onurefe/Wirebonder/Hardware/bom.xlsx

Part | Value | Link | Price | Qty
C1, C2 | 0.47u | https://ozdisan.com/passive-components/capacitors/smt-smd-and-mlcc-capacitors/CL10B474KO8NNNC | 0.00926 | 2 | 0.01852
C3-C8, C13, C16-C19, C21-C25, C30, C32, C38, C41, C45-C48, C51, C52, C56-C58, C60, C64, C66-C81, C87, C89 | 100n | https://ozdisan.com/passive-components/capacitors/smt-smd-and-mlcc-capacitors/CL10B104KB8NNNC | 0.00448 | 49 | 0.21952
C9, C10 | 10n | https://ozdisan.com/passive-components/capacitors/smt-smd-and-mlcc-capacitors/CL10B103KB8NNNC | 0.00532 | 2 | 0.01064
C11, C12 | 18p | https://ozdisan.com/passive-components/capacitors/smt-smd-and-mlcc-capacitors/CL10C180JB8NNNC | 0.00487 | 2 | 0.00974
C14 | 4.7u | https://ozdisan.com/passive-components/capacitors/smt-smd-and-mlcc-capacitors/CL10A475KQ8NNNC | 0.01079 | 1 | 0.01079
C15, C20, C86, C88, C90, C93, C94 | 1u | https://ozdisan.com/passive-components/capacitors/smt-smd-and-mlcc-capacitors/CL10B105KA8NNNC | 0.00926 | 7 | 0.06482
C26, C27 | 6.8n %5 | https://ozdisan.com/passive-components/capacitors/smt-smd-and-mlcc-capacitors/CL21B682JBANNNC | 0.06185 | 2 | 0.1237
C28 | 680p %5 | https://ozdisan.com/passive-components/capacitors/smt-smd-and-mlcc-capacitors/CL10C681JB8NNNC | 0.01257 | 1 | 0.01257
C29, C43, C44 | 1u 25v | https://ozdisan.com/passive-components/capacitors/smt-smd-and-mlcc-capacitors/CL10B105KA8NNNC | 0.00926 | 3 | 0.02778
C33, C34 | 10n %5 C0G | https://ozdisan.com/passive-components/capacitors/smt-smd-and-mlcc-capacitors/CL10C103JA8NNNC | 0.07588 | 2 | 0.15176
C35-C37, C39, C40 | 12p %5 | https://ozdisan.com/passive-components/capacitors/smt-smd-and-mlcc-capacitors/CL10C120JB8NNNC | 0.00532 | 5 | 0.0266
C31, C42 | 10u 25V | https://ozdisan.com/passive-components/capacitors/smt-smd-and-mlcc-capacitors/CL31A106KBHNNNE | 0.1049 | 2 | 0.2098
C49 | 120n | https://ozdisan.com/passive-components/capacitors/smt-smd-and-mlcc-capacitors/CL21B124JACNNNC | 0.03221 | 1 | 0.03221
C50, C59, C65, C85 | 10u 25v | https://ozdisan.com/passive-components/capacitors/smt-smd-and-mlcc-capacitors/CL21A106KAYNNNE | 0.04807 | 4 | 0.19228
C53 | 100n | https://ozdisan.com/passive-components/capacitors/smt-smd-and-mlcc-capacitors/CL10B104KB8NNNC | 0.00448 | 1 | 0.00448
C54, C55, C62 | 1n | https://ozdisan.com/passive-components/capacitors/smt-smd-and-mlcc-capacitors/CL10B102KB8NNNC | 0.00532 | 3 | 0.01596
C61 | 12n %5 | https://ozdisan.com/passive-components/capacitors/smt-smd-and-mlcc-capacitors/CL21B123KBANNNC | 0.05173 | 1 | 0.05173
C63, C84 | 10n %5 | https://ozdisan.com/passive-components/capacitors/smt-smd-and-mlcc-capacitors/GRM1885C1H103JA01D | 0.0405 | 2 | 0.081
C82 | 22n %5 | https://ozdisan.com/passive-components/capacitors/smt-smd-and-mlcc-capacitors/06035C223JAT2A | 0.03087 | 1 | 0.03087
C83 | 68n %5 | https://ozdisan.com/passive-components/capacitors/smt-smd-and-mlcc-capacitors/CL10B683KB8NNNC | 0.00772 | 1 | 0.00772
C91 | 4.7u Tantalum | https://ozdisan.com/passive-components/capacitors/tantalum-capacitors/T491B475M020AT | 0.2062 | 1 | 0.2062
C92 | 10u | https://ozdisan.com/passive-components/capacitors/smt-smd-and-mlcc-capacitors/CL21A106KAYNNNE | 0.04807 | 1 | 0.04807
C95 | 1000u 16v | https://ozdisan.com/passive-components/capacitors/aluminum-capacitors/PKLH-025V102MG200-TA5-0 | 0.13444 | 1 | 0.13444
C96 | 1000u 25v | https://ozdisan.com/passive-components/capacitors/aluminum-capacitors/PKLH-025V102MG200-TA5-0 | 0.13444 | 1 | 0.13444
C97 | 2200u 25v | https://ozdisan.com/passive-components/capacitors/aluminum-capacitors/PKLH-025V222MI220-TA5-0 | 0.29935 | 1 | 0.29935
D1, D2, D6-D10 | 1N4148 | https://ozdisan.com/power-semiconductors/diodes-diode-modules-and-rectifiers/general-purpose-diodes/1N4148WR200001 | 0.02794 | 7 | 0.19558
D3-D5 | 1N4148W | https://ozdisan.com/power-semiconductors/diodes-diode-modules-and-rectifiers/general-purpose-diodes/1N4148W-HT | 0.01562 | 3 | 0.04686
J1, J2, J7 | DG250-3-5-04P-11-00AH | https://ozdisan.com/Product/Detail/652297/DG250-3-5-04P-11-00AH | 0.28808 | 3 | 0.86424
J3 | Conn_02x08_Odd_Even | https://ozdisan.com/connectors-and-interconnects/headers/pin-headers/L-KLS1-207-2-16-S | 0.06051 | 1 | 0.06051
J4, J11-J14, J16-J23 | DG250-3-5-02P-11-00AH | https://ozdisan.com/connectors-and-interconnects/terminal-blocks/pcb-terminal-blocks/DG250-3-5-02P-11-00AH | 0.10187 | 13 | 1.32431
J5, J25 | DG301-5-0-04P-12-00AH | https://ozdisan.com/connectors-and-interconnects/terminal-blocks/pcb-terminal-blocks/DG301-5-0-04P-12-00AH | 0.21126 | 2 | 0.42252
J6, J24 | DG301-5-0-02P-12-00AH | https://ozdisan.com/connectors-and-interconnects/terminal-blocks/pcb-terminal-blocks/DG301-5-0-02P-12-00AH | 0.11212 | 2 | 0.22424
J8 | Conn_02x07_Odd_Even | https://ozdisan.com/connectors-and-interconnects/headers/box-headers/5BH1SDD88-14G05AL-00 | 0.14237 | 1 | 0.14237
J9 | Conn_02x08_Odd_Even | https://ozdisan.com/connectors-and-interconnects/headers/box-headers/DS1013-16SSIB1 | 0.09492 | 1 | 0.09492
J10 | DS1021-1X14SF11-B | https://ozdisan.com/connectors-and-interconnects/headers/pin-headers/DS1021-1X14SF11-B | 0.09638 | 1 | 0.09638
J15 | DG250-3-5-06P-11-00AH | https://ozdisan.com/connectors-and-interconnects/terminal-blocks/pcb-terminal-blocks/DG250-3-5-06P-11-00AH | 0.28808 | 1 | 0.28808
L1 | RC1415U-101K | https://ozdisan.com/passive-components/inductors/fixed-inductors/RC1415U-101K | 1.21707 | 1 | 1.21707
Q1, Q2, Q19, Q20, Q24, Q26, Q33 | BC817-40 | https://ozdisan.com/power-semiconductors/transistors/discrete-transistors/BC817-40215 | 0.02586 | 7 | 0.18102
Q3, Q5, Q22, Q28, Q31, Q35 | BCP53-16 | https://ozdisan.com/power-semiconductors/transistors/discrete-transistors/BCP53-16115 | 0.13099 | 6 | 0.78594
Q4, Q6, Q23, Q29, Q32, Q36 | BCP56-16 | https://ozdisan.com/power-semiconductors/transistors/discrete-transistors/BCP56-16115 | 0.1311 | 6 | 0.7866
Q7 | MJD45H11T4G | https://ozdisan.com/Product/Detail/448870/MJD45H11T4G | 0.55649 | 1 | 0.55649
Q8 | MJD44H11T4G | https://ozdisan.com/Product/Detail/448869/MJD44H11T4G | 0.39273 | 1 | 0.39273
Q9-Q14 | P25B6EB | https://ozdisan.com/power-semiconductors/mosfets/discrete-mosfets/P25B6EB-5071 | 0.7636 | 6 | 4.5816
Q15-Q18, Q21, Q27, Q30, Q34 | BC807-40 | https://ozdisan.com/power-semiconductors/transistors/discrete-transistors/BC807-40215 | 0.02281 | 8 | 0.18248
Q25 | FDD3860 | https://ozdisan.com/power-semiconductors/mosfets/discrete-mosfets/FDD3860 | 1.00545 | 1 | 1.00545
R2, R49, R51 | 2.2k %1 | https://ozdisan.com/passive-components/resistors/smt-smd-and-chip-resistors/0603SAF2201T5E | 0.00221 | 3 | 0.00663
R4, R6, R9, R29 | 3.3k %1 | https://ozdisan.com/passive-components/resistors/smt-smd-and-chip-resistors/0603SAF3301T5E | 0.00221 | 4 | 0.00884
R15, R17, R35, R36 | 1M | https://ozdisan.com/passive-components/resistors/smt-smd-and-chip-resistors/0603SAJ0105T5E | 0.00169 | 4 | 0.00676
R16, R19 | 1R %1 1/4 W | https://ozdisan.com/passive-components/resistors/smt-smd-and-chip-resistors/1206S4F100KT5E | 0.00884 | 2 | 0.01768
R18, R20 | 0.33R %1 1/4W | https://ozdisan.com/passive-components/resistors/smt-smd-and-chip-resistors/HP06W2F330LT5E | 0.0961 | 2 | 0.1922
R1, R3, R5, R7, R8, R10-R14, R21, R22, R78, R84-R89, R94-R104, R107, R109-R112, R116, R117, R122, R126, R127, R137, R138, R159-R166, R169, R171 | 10k | https://ozdisan.com/passive-components/resistors/smt-smd-and-chip-resistors/0603SAF1002T5E | 0.00221 | 52 | 0.11492
R23, R26 | 536R %1 | https://ozdisan.com/passive-components/resistors/smt-smd-and-chip-resistors/0603SAF5360T5E | 0.00221 | 2 | 0.00442
R24 | 887R %1 | https://ozdisan.com/passive-components/resistors/smt-smd-and-chip-resistors/0603SAF8870T5E | 0.00221 | 1 | 0.00221
R25 | 1430R %1 | https://ozdisan.com/passive-components/resistors/smt-smd-and-chip-resistors/0603SAF1431T5E | 0.00221 | 1 | 0.00221
R27, R33 | 680R %1 | https://ozdisan.com/passive-components/resistors/smt-smd-and-chip-resistors/0603SAF6800T5E | 0.00221 | 2 | 0.00442
R28, R30 | 470R %1 | https://ozdisan.com/passive-components/resistors/smt-smd-and-chip-resistors/0603SAF4700T5E | 0.00221 | 2 | 0.00442
R40, R41, R67 | 56R %1 | https://ozdisan.com/passive-components/resistors/smt-smd-and-chip-resistors/0603SAF560JT5E | 0.00221 | 3 | 0.00663
R31, R32, R34, R42, R79-R83, R105, R106 | 0R | https://ozdisan.com/passive-components/resistors/smt-smd-and-chip-resistors/0603SAJ0000TDE | 0.00221 | 11 | 0.02431
R37, R38, R43, R44 | 47R %1 | https://ozdisan.com/passive-components/resistors/smt-smd-and-chip-resistors/0603SAF470JT5E | 0.00221 | 4 | 0.00884
R39, R45, R46 | 8.2k %1 | https://ozdisan.com/passive-components/resistors/smt-smd-and-chip-resistors/0603SAF8201T5E | 0.00221 | 3 | 0.00663
R47, R48 | 0.33R | https://ozdisan.com/passive-components/resistors/smt-smd-and-chip-resistors/25121WF330LT4E | 0.10712 | 2 | 0.21424
R50 | 2.15k %1 | https://ozdisan.com/passive-components/resistors/smt-smd-and-chip-resistors/0603SAF2151T5E | 0.00221 | 1 | 0.00221
R52 | 61.9R %1 | https://ozdisan.com/passive-components/resistors/smt-smd-and-chip-resistors/0603SAF619JT5E | 0.00221 | 1 | 0.00221
R53 | 1R 1/3W %1 | https://ozdisan.com/passive-components/resistors/smt-smd-and-chip-resistors/CQ07S3F100KT5E | 0.05112 | 1 | 0.05112
R54, R144, R145 | 56R | https://ozdisan.com/passive-components/resistors/smt-smd-and-chip-resistors/0603SAF560JT5E | 0.00221 | 3 | 0.00663
R55, R146 | 4.99k %1 | https://ozdisan.com/passive-components/resistors/smt-smd-and-chip-resistors/0603SAF4991T5E | 0.002221 | 2 | 0.004442
R56-R59, R65, R66 | 8.2R | https://ozdisan.com/passive-components/resistors/smt-smd-and-chip-resistors/0603SAJ082JT5E | 0.00168 | 6 | 0.01008
R60 | 2.49k %1 | https://ozdisan.com/passive-components/resistors/smt-smd-and-chip-resistors/0603SAF2491T5E | 0.002221 | 1 | 0.002221
R61 | 31.6k %1 | https://ozdisan.com/passive-components/resistors/smt-smd-and-chip-resistors/0603SAF3162T5E | 0.00221 | 1 | 0.00221
R62, R63, R69 | 47R | https://ozdisan.com/passive-components/resistors/smt-smd-and-chip-resistors/0603SAF470JT5E | 0.00221 | 3 | 0.00663
R64 | 6.65k %1 | https://ozdisan.com/passive-components/resistors/smt-smd-and-chip-resistors/0603SAF6651T5E | 0.002221 | 1 | 0.002221
R68 | 33.2k %1 | https://ozdisan.com/passive-components/resistors/smt-smd-and-chip-resistors/0603SAF3322T5E | 0.00221 | 1 | 0.00221
R70, R74 | 4.87k %1 | https://ozdisan.com/passive-components/resistors/smt-smd-and-chip-resistors/0603SAF4871T5E | 0.00221 | 2 | 0.00442
R71, R73 | 14.3k %1 | https://ozdisan.com/passive-components/resistors/smt-smd-and-chip-resistors/0603SAF1432T5E | 0.00221 | 2 | 0.00442
R72 | 57.6k %1 | https://ozdisan.com/passive-components/resistors/smt-smd-and-chip-resistors/0603SAF5762T5E | 0.00221 | 1 | 0.00221
R75 | 100mohm %1 2.5W | https://ozdisan.com/passive-components/resistors/precision-power-and-shunt-resistors/CMS-R100-1-0-3000 | 0.57604 | 1 | 0.57604
R76, R77, R133, R149, R150 | 2.2k | https://ozdisan.com/passive-components/resistors/smt-smd-and-chip-resistors/0603SAF2201T5E | 0.00221 | 5 | 0.01105
R90-R93, R151-R158 | 470R | https://ozdisan.com/passive-components/resistors/smt-smd-and-chip-resistors/0603SAF4700T5E | 0.00221 | 12 | 0.02652
R108, R114, R115, R124, R125, R132, R135, R136 | 1k | https://ozdisan.com/passive-components/resistors/smt-smd-and-chip-resistors/0603SAF1001T5E | 0.00221 | 8 | 0.01768
R113 | 4.7k | https://ozdisan.com/passive-components/resistors/smt-smd-and-chip-resistors/0603SAJ0472T5E | 0.00169 | 1 | 0.00169
R118, R119, R128, R129, R139, R140, R170 | 120R | https://ozdisan.com/passive-components/resistors/smt-smd-and-chip-resistors/0603WAJ0121T5E | 0.00169 | 7 | 0.01183
R120, R121, R130, R131, R141, R142 | 470R 1/4W | https://ozdisan.com/passive-components/resistors/smt-smd-and-chip-resistors/HP05W3F4700T5E | 0.0104 | 6 | 0.0624
R123 | 2.2k 1/4W | https://ozdisan.com/passive-components/resistors/smt-smd-and-chip-resistors/HP05W3F2201T5E | 0.0104 | 1 | 0.0104
R134 | 18R | https://ozdisan.com/passive-components/resistors/smt-smd-and-chip-resistors/0603SAJ0180T5E | 0.00169 | 1 | 0.00169
R143 | 1k %1 | https://ozdisan.com/passive-components/resistors/smt-smd-and-chip-resistors/0603SAF1001T5E | 0.00221 | 1 | 0.00221
R147 | 5.9k %1 | https://ozdisan.com/passive-components/resistors/smt-smd-and-chip-resistors/0805S8F5901T5E | 0.00377 | 1 | 0.00377
R148 | 665R %1 | https://ozdisan.com/passive-components/resistors/smt-smd-and-chip-resistors/0603SAF6650T5E | 0.00221 | 1 | 0.00221
R167, R168 | 10k %1 | https://ozdisan.com/passive-components/resistors/smt-smd-and-chip-resistors/0603SAF1002T5E | 0.00221 | 2 | 0.00442
RV1 | 10k | https://ozdisan.com/electromechanical-components/potentiometers-and-variable-resistors/trimmer-potentiometers/3313J-1-103E | 0.58363 | 1 | 0.58363
TP1-TP18 | TestPoint_2Pole | https://ozdisan.com/connectors-and-interconnects/headers/pin-headers/L-KLS1-207-1-02-S | 0.1293 | 18 | 2.3274
U1, U2 | DRV8825 | https://ozdisan.com/maker-ve-iot-urunleri/arduino/arduino-modulleri/DRV8825-MOTOR-DRIVER | 3.0683 | 2 | 6.1366
U3 | STM32F446RCTx | https://ozdisan.com/integrated-circuits-ics/embedded-ics/microcontrollers/STM32F446RCT6 | 14.41001 | 1 | 14.41001
U4, U5 | AD8656 | https://ozdisan.com/integrated-circuits-ics/linear-ics/amplifiers/AD8656ARZ-REEL7 | 5.66346 | 2 | 11.32692
U6, U7, U9 | IRS2005S | https://ozdisan.com/integrated-circuits-ics/power-management-ics/power-drivers/IRS2005STRPBF | 1.63317 | 3 | 4.89951
U8, U10 | MCP6282 | https://ozdisan.com/integrated-circuits-ics/linear-ics/amplifiers/MCP6282T-ESN | 1.96988 | 2 | 3.93976
U11 | ISO7221 | https://ozdisan.com/integrated-circuits-ics/interfaces-and-peripherals-ics/digital-isolators/ISO7221ADR | 4.9247 | 1 | 4.9247
U12 | PCA9535 | https://ozdisan.com/integrated-circuits-ics/interfaces-and-peripherals-ics/io-expanders/PCA9535DBQR | 1.99925 | 1 | 1.99925
U13 | PCA9538 | https://ozdisan.com/integrated-circuits-ics/interfaces-and-peripherals-ics/io-expanders/PCA9538PWR | 1.83073 | 1 | 1.83073
U14 | MC33204 | https://ozdisan.com/integrated-circuits-ics/linear-ics/amplifiers/MC33204DR2G | 1.34167 | 1 | 1.34167
U15, U16 | LTV-847S | https://ozdisan.com/Product/Detail/362511/LTV-847S | 0.47358 | 2 | 0.94716
U17 | L7812 | https://ozdisan.com/integrated-circuits-ics/power-management-ics/linear-voltage-regulators/L7812CD2T-TR | 0.46966 | 1 | 0.46966
U18 | MCP6001 | https://ozdisan.com/integrated-circuits-ics/linear-ics/amplifiers/MCP6001UT-IOT | 0.61226 | 1 | 0.61226
U19 | TLV70033_SOT23-5 | https://ozdisan.com/integrated-circuits-ics/power-management-ics/linear-voltage-regulators/TLV70033DDCR | 0.22709 | 1 | 0.22709
U20 | TLV73333PDBV | https://ozdisan.com/Product/Detail/532538/TLV73333PDBVR | 0.16754 | 1 | 0.16754
Y1 | 8MHz 85ohms | https://ozdisan.com/passive-components/crystals-oscillators-and-resonators/crystals/H130B-8-000-18-3030-EXT- | 0.44011 | 1 | 0.44011
Power supply | Power supply +5v, +15v,-15v | https://www.direnc.net/uc-cikisli-switch-mode-adaptor-5v-/-15v-/-15v-132w
Part cost per board | 73.618884
Power supply cost | 34.09
Total cost(two boards) | 181.327768
