onurefe/Wirebonder/Hardware/contact_sensors.kicad_sch

## KiCad design Hardware/contact_sensors.kicad_sch (2024-12-15, an earlier design)

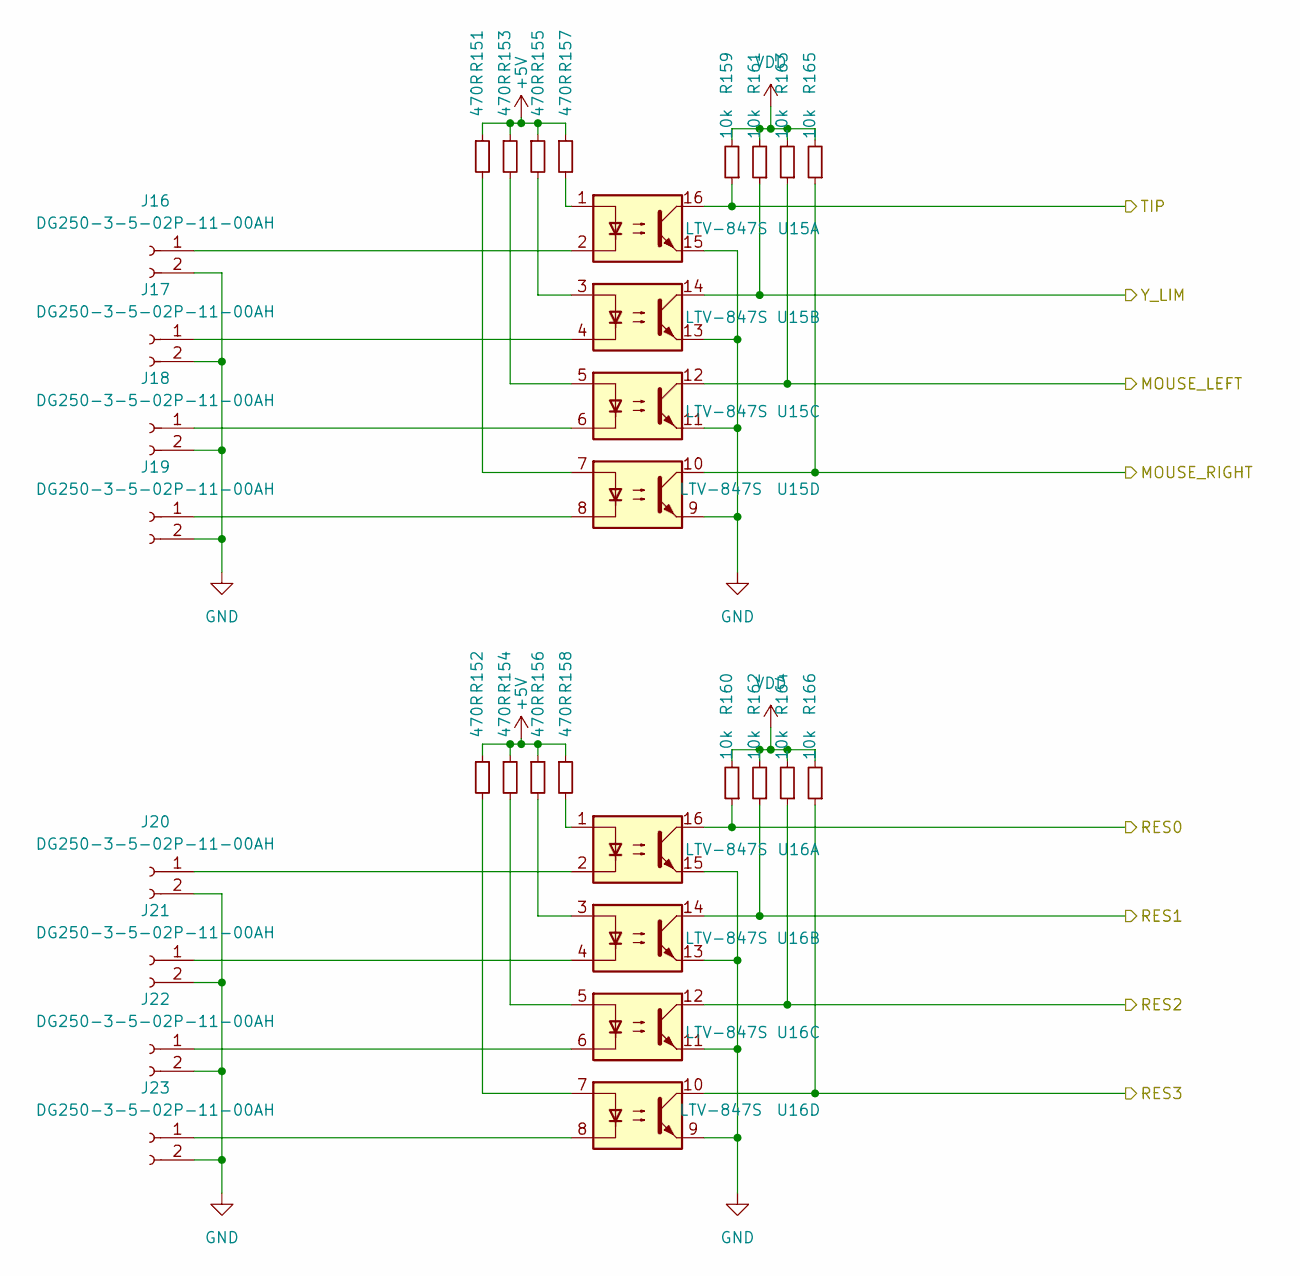
[picture p1: schematic contact_sensors.kicad_sch]

Parts:
J16, J17, J18, J19, J20, J21, J22, J23: DG250-3-5-02P-11-00AH
R151, R152, R153, R154, R155, R156, R157, R158: 470R; R_0603_1608Metric_Pad0.98x0.95mm_HandSolder
R159, R160, R161, R162, R163, R164, R165, R166: 10k; R_0603_1608Metric_Pad0.98x0.95mm_HandSolder
U15, U16: LTV-847S; SMDIP-16_W9.53mm

Connections:
+5V: R151.1, R152.1, R153.1, R154.1, R155.1, R156.1, R157.1, R158.1
GND: J16.2, J17.2, J18.2, J19.2, J20.2, J21.2, J22.2, J23.2, U15.9, U15.11, U15.13, U15.15, U16.9, U16.11, U16.13, U16.15
MOUSE_LEFT: R163.1, U15.12
MOUSE_RIGHT: R165.1, U15.10
unnamed: J16.1, U15.2
unnamed: J17.1, U15.4
unnamed: J18.1, U15.6
unnamed: J19.1, U15.8
unnamed: J20.1, U16.2
unnamed: J21.1, U16.4
unnamed: J22.1, U16.6
unnamed: J23.1, U16.8
unnamed: R151.2, U15.7
unnamed: R152.2, U16.7
unnamed: R153.2, U15.5
unnamed: R154.2, U16.5
unnamed: R155.2, U15.3
unnamed: R156.2, U16.3
unnamed: R157.2, U15.1
unnamed: R158.2, U16.1
RES0: R160.1, U16.16
RES1: R162.1, U16.14
RES2: R164.1, U16.12
RES3: R166.1, U16.10
TIP: R159.1, U15.16
VDD: R159.2, R160.2, R161.2, R162.2, R163.2, R164.2, R165.2, R166.2
Y_LIM: R161.1, U15.14
