onurefe/Wirebonder/Hardware/drives.kicad_sch

## KiCad design Hardware/drives.kicad_sch (2024-12-15, an earlier design)

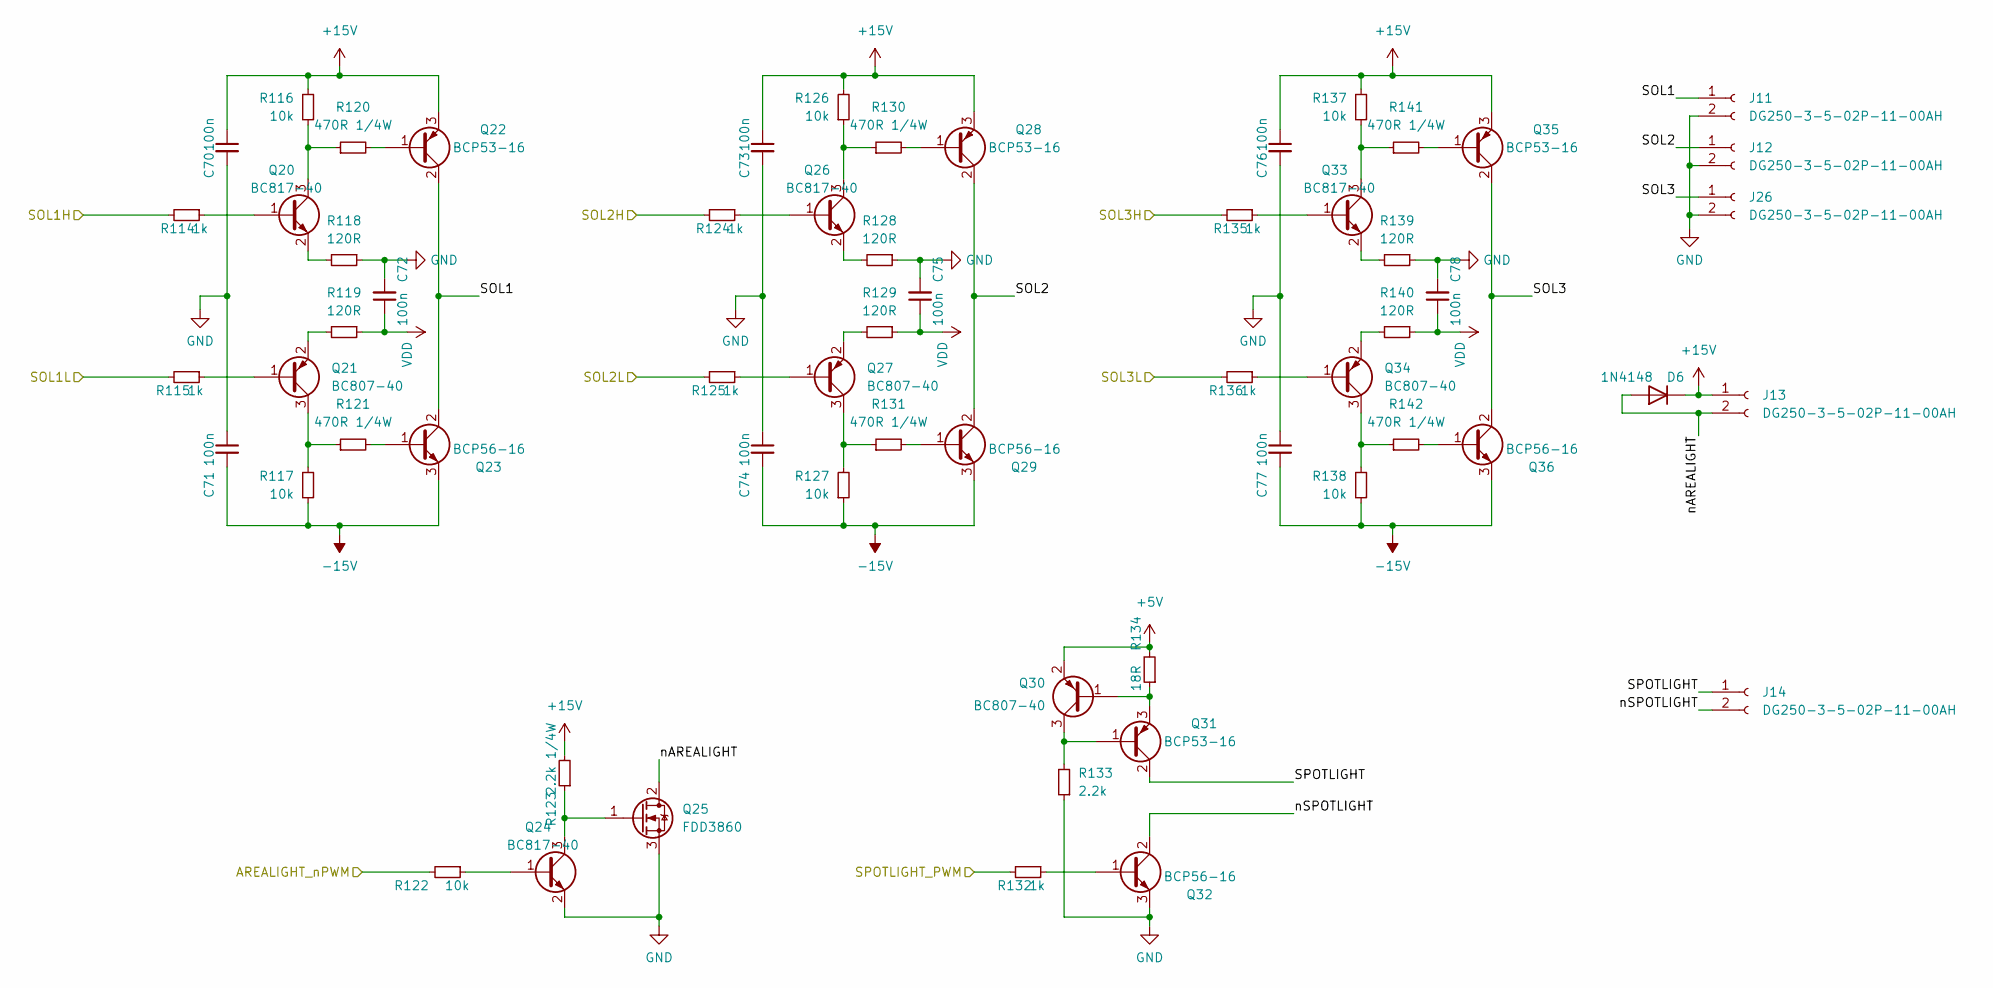
[picture p2: schematic drives.kicad_sch]

Parts:
C70, C71, C72, C73, C74, C75, C76, C77, C78: 100n; C_0603_1608Metric_Pad1.08x0.95mm_HandSolder
D6: 1N4148; D_SOD-123
J11, J12, J13, J14, J26: DG250-3-5-02P-11-00AH
Q20, Q24, Q26, Q33: BC817-40; SOT-23
Q21, Q27, Q30, Q34: BC807-40; SOT-23
Q22, Q28, Q31, Q35: BCP53-16; SOT-223
Q23, Q29, Q32, Q36: BCP56-16; SOT-223
Q25: FDD3860; TO-252-2
R114, R115, R124, R125, R132, R135, R136: 1k; R_0603_1608Metric_Pad0.98x0.95mm_HandSolder
R116, R117, R122, R126, R127, R137, R138: 10k; R_0603_1608Metric_Pad0.98x0.95mm_HandSolder
R118, R119, R128, R129, R139, R140: 120R; R_0603_1608Metric_Pad0.98x0.95mm_HandSolder
R120, R121, R130, R131, R141, R142: 470R 1/4W; R_0805_2012Metric_Pad1.20x1.40mm_HandSolder
R123: 2.2k 1/4W; R_0805_2012Metric_Pad1.20x1.40mm_HandSolder
R133: 2.2k; R_0603_1608Metric_Pad0.98x0.95mm_HandSolder
R134: 18R; R_0603_1608Metric_Pad0.98x0.95mm_HandSolder

Connections:
+5V: Q30.2 (E), R134.2
+15V: C70.1, C73.1, C76.1, D6.1 (K), J13.1, Q22.3 (E), Q28.3 (E), Q35.3 (E), R116.2, R123.2, R126.2, R137.2
-15V: C71.2, C74.2, C77.2, Q23.3 (E), Q29.3 (E), Q36.3 (E), R117.1, R127.1, R138.1
AREALIGHT_nPWM: R122.2
GND: C70.2, C71.1, C72.2, C73.2, C74.1, C75.2, C76.2, C77.1, C78.2, J11.2, J12.2, J26.2, Q24.2 (E), Q25.3 (S), Q32.3 (E), R118.1, R128.1, R133.1, R139.1
unnamed: Q20.1 (B), R114.1
unnamed: Q20.2 (E), R118.2
unnamed: Q20.3 (C), R116.1, R120.1
unnamed: Q21.1 (B), R115.1
unnamed: Q21.2 (E), R119.2
unnamed: Q21.3 (C), R117.2, R121.1
unnamed: Q22.1 (B), R120.2
unnamed: Q23.1 (B), R121.2
unnamed: Q24.1 (B), R122.1
unnamed: Q24.3 (C), Q25.1 (G), R123.1
unnamed: Q26.1 (B), R124.1
unnamed: Q26.2 (E), R128.2
unnamed: Q26.3 (C), R126.1, R130.1
unnamed: Q27.1 (B), R125.1
unnamed: Q27.2 (E), R129.2
unnamed: Q27.3 (C), R127.2, R131.1
unnamed: Q28.1 (B), R130.2
unnamed: Q29.1 (B), R131.2
unnamed: Q30.1 (B), Q31.3 (E), R134.1
unnamed: Q30.3 (C), Q31.1 (B), R133.2
unnamed: Q32.1 (B), R132.1
unnamed: Q33.1 (B), R135.1
unnamed: Q33.2 (E), R139.2
unnamed: Q33.3 (C), R137.1, R141.1
unnamed: Q34.1 (B), R136.1
unnamed: Q34.2 (E), R140.2
unnamed: Q34.3 (C), R138.2, R142.1
unnamed: Q35.1 (B), R141.2
unnamed: Q36.1 (B), R142.2
SOL1: J11.1, Q22.2 (C), Q22.4 (C), Q23.2 (C), Q23.4 (C)
SOL1H: R114.2
SOL1L: R115.2
SOL2: J12.1, Q28.2 (C), Q28.4 (C), Q29.2 (C), Q29.4 (C)
SOL2H: R124.2
SOL2L: R125.2
SOL3: J26.1, Q35.2 (C), Q35.4 (C), Q36.2 (C), Q36.4 (C)
SOL3H: R135.2
SOL3L: R136.2
SPOTLIGHT: J14.1, Q31.2 (C), Q31.4 (C)
SPOTLIGHT_PWM: R132.2
VDD: C72.1, C75.1, C78.1, R119.1, R129.1, R140.1
nAREALIGHT: D6.2 (A), J13.2, Q25.2 (D)
nSPOTLIGHT: J14.2, Q32.2 (C), Q32.4 (C)
