onurefe/Wirebonder/Hardware/lvdt.kicad_sch

## KiCad design Hardware/lvdt.kicad_sch (2024-12-15, an earlier design)

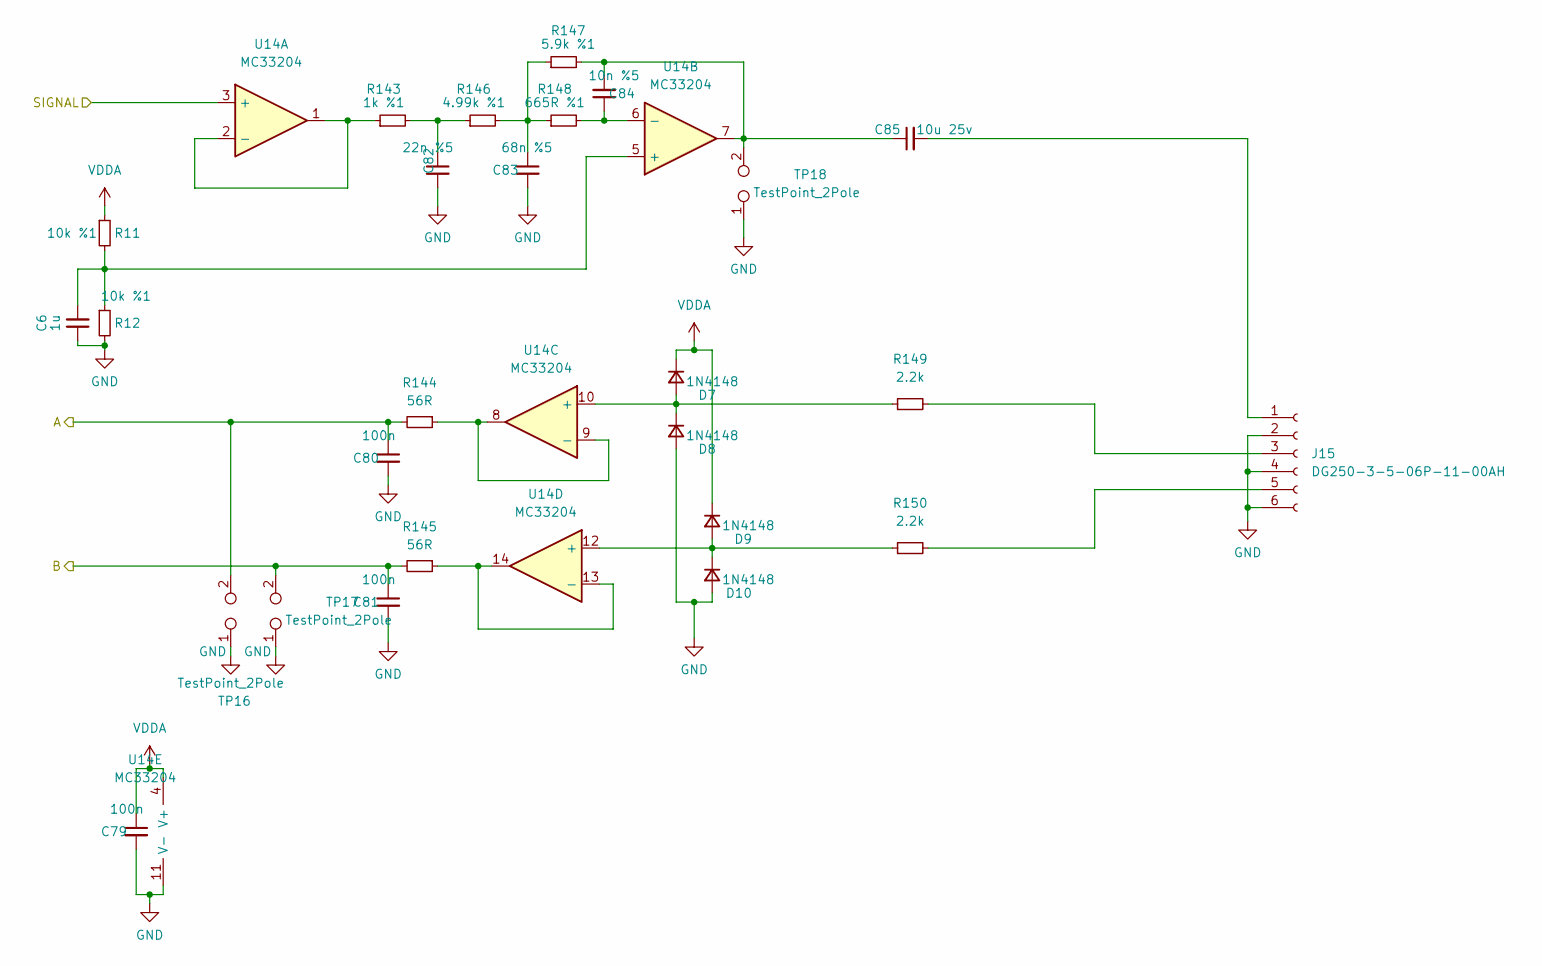
[picture p3: schematic lvdt.kicad_sch]

Parts:
C6: 1u; C_0603_1608Metric_Pad1.08x0.95mm_HandSolder
C79, C80, C81: 100n; C_0603_1608Metric_Pad1.08x0.95mm_HandSolder
C82: 22n %5; C_0603_1608Metric_Pad1.08x0.95mm_HandSolder
C83: 68n %5; C_0603_1608Metric_Pad1.08x0.95mm_HandSolder
C84: 10n %5; C_0603_1608Metric_Pad1.08x0.95mm_HandSolder
C85: 10u 25v; C_0805_2012Metric_Pad1.18x1.45mm_HandSolder
D7, D8, D9, D10: 1N4148; D_SOD-123
J15: DG250-3-5-06P-11-00AH
R11, R12: 10k %1; R_0603_1608Metric_Pad0.98x0.95mm_HandSolder
R143: 1k %1; R_0603_1608Metric_Pad0.98x0.95mm_HandSolder
R144, R145: 56R; R_0603_1608Metric_Pad0.98x0.95mm_HandSolder
R146: 4.99k %1; R_0603_1608Metric_Pad0.98x0.95mm_HandSolder
R147: 5.9k %1; R_0805_2012Metric_Pad1.20x1.40mm_HandSolder
R148: 665R %1; R_0603_1608Metric_Pad0.98x0.95mm_HandSolder
R149, R150: 2.2k; R_0603_1608Metric_Pad0.98x0.95mm_HandSolder
TP16, TP17, TP18: TestPoint_2Pole; PinHeader_1x02_P2.54mm_Vertical
U14: MC33204; SOIC-14_3.9x8.7mm_P1.27mm

Connections:
A: C80.1, R144.2, TP16.2
B: C81.1, R145.2, TP17.2
GND: C6.1, C79.2, C80.2, C81.2, C82.2, C83.2, D8.2 (A), D10.2 (A), J15.2, J15.4, J15.6, R12.2, TP16.1, TP17.1, TP18.1, U14.11 (V-)
unnamed: C6.2, R11.2, R12.1, U14.5 (+)
unnamed: C82.1, R143.2, R146.1
unnamed: C83.1, R146.2, R147.1, R148.1
unnamed: C84.1, R148.2, U14.6 (-)
unnamed: C84.2, C85.1, R147.2, TP18.2, U14.7
unnamed: C85.2, J15.1
unnamed: D7.2 (A), D8.1 (K), R149.1, U14.10 (+)
unnamed: D9.2 (A), D10.1 (K), R150.1, U14.12 (+)
unnamed: J15.3, R149.2
unnamed: J15.5, R150.2
unnamed: R143.1, U14.1, U14.2 (-)
unnamed: R144.1, U14.8, U14.9 (-)
unnamed: R145.1, U14.13 (-), U14.14
SIGNAL: U14.3 (+)
VDDA: C79.1, D7.1 (K), D9.1 (K), R11.1, U14.4 (V+)
