onurefe/Wirebonder/Hardware/regulators.kicad_sch

## KiCad design Hardware/regulators.kicad_sch (2024-12-15, an earlier design)

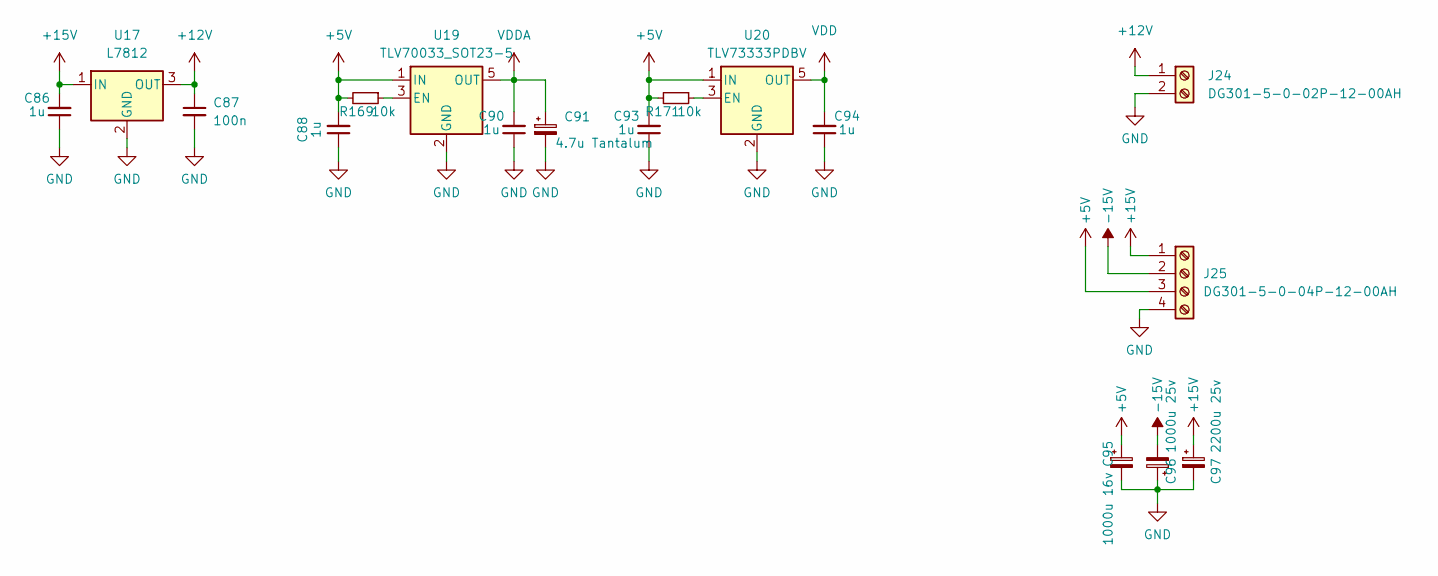
[picture p4: schematic regulators.kicad_sch]

Parts:
C86, C88, C90, C93, C94: 1u; C_0603_1608Metric_Pad1.08x0.95mm_HandSolder
C87: 100n; C_0603_1608Metric_Pad1.08x0.95mm_HandSolder
C91: 4.7u Tantalum; CP_EIA-3528-21_Kemet-B_Pad1.50x2.35mm_HandSolder
C95: 1000u 16v; CP_Radial_D10.0mm_P5.00mm
C96: 1000u 25v; CP_Radial_D10.0mm_P5.00mm
C97: 2200u 25v; CP_Radial_D12.5mm_P5.00mm
J24: DG301-5-0-02P-12-00AH; DG301-5.0-02P-12-00AH
J25: DG301-5-0-04P-12-00AH; DG301-5.0-04P-12-00AH
R169, R171: 10k; R_0603_1608Metric_Pad0.98x0.95mm_HandSolder
U17: L7812; TO-263-2
U19: TLV70033_SOT23-5; SOT-23-5
U20: TLV73333PDBV; SOT-23-5

Connections:
+5V: C88.2, C93.2, C95.1, J25.3, R169.2, R171.2, U19.1 (IN), U20.1 (IN)
+12V: C87.1, J24.1, U17.3 (OUT)
+15V: C86.2, C97.1, J25.1, U17.1 (IN)
-15V: C96.2, J25.2
GND: C86.1, C87.2, C88.1, C90.1, C91.2, C93.1, C94.1, C95.2, C96.1, C97.2, J24.2, J25.4, U17.2 (GND), U19.2 (GND), U20.2 (GND)
unnamed: R169.1, U19.3 (EN)
unnamed: R171.1, U20.3 (EN)
VDD: C94.2, U20.5 (OUT)
VDDA: C90.2, C91.1, U19.5 (OUT)
