onurefe/Wirebonder/Hardware/serial.kicad_sch

## KiCad design Hardware/serial.kicad_sch (2024-12-15, an earlier design)

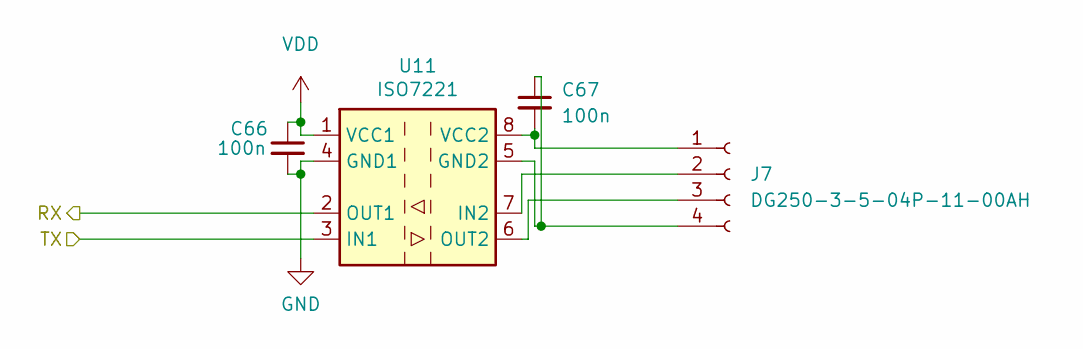
[picture p5: schematic serial.kicad_sch]

Parts:
C66, C67: 100n; C_0603_1608Metric_Pad1.08x0.95mm_HandSolder
J7: DG250-3-5-04P-11-00AH
U11: ISO7221; SOIC-8_3.9x4.9mm_P1.27mm

Connections:
GND: C66.2, U11.4 (GND1)
unnamed: C67.1, J7.4, U11.5 (GND2)
unnamed: C67.2, J7.1, U11.8 (VCC2)
unnamed: J7.2, U11.7 (IN2)
unnamed: J7.3, U11.6 (OUT2)
RX: U11.2 (OUT1)
TX: U11.3 (IN1)
VDD: C66.1, U11.1 (VCC1)
