onurefe/Wirebonder/Hardware/ultrasonic.kicad_sch

## KiCad design Hardware/ultrasonic.kicad_sch (2024-12-15, an earlier design)

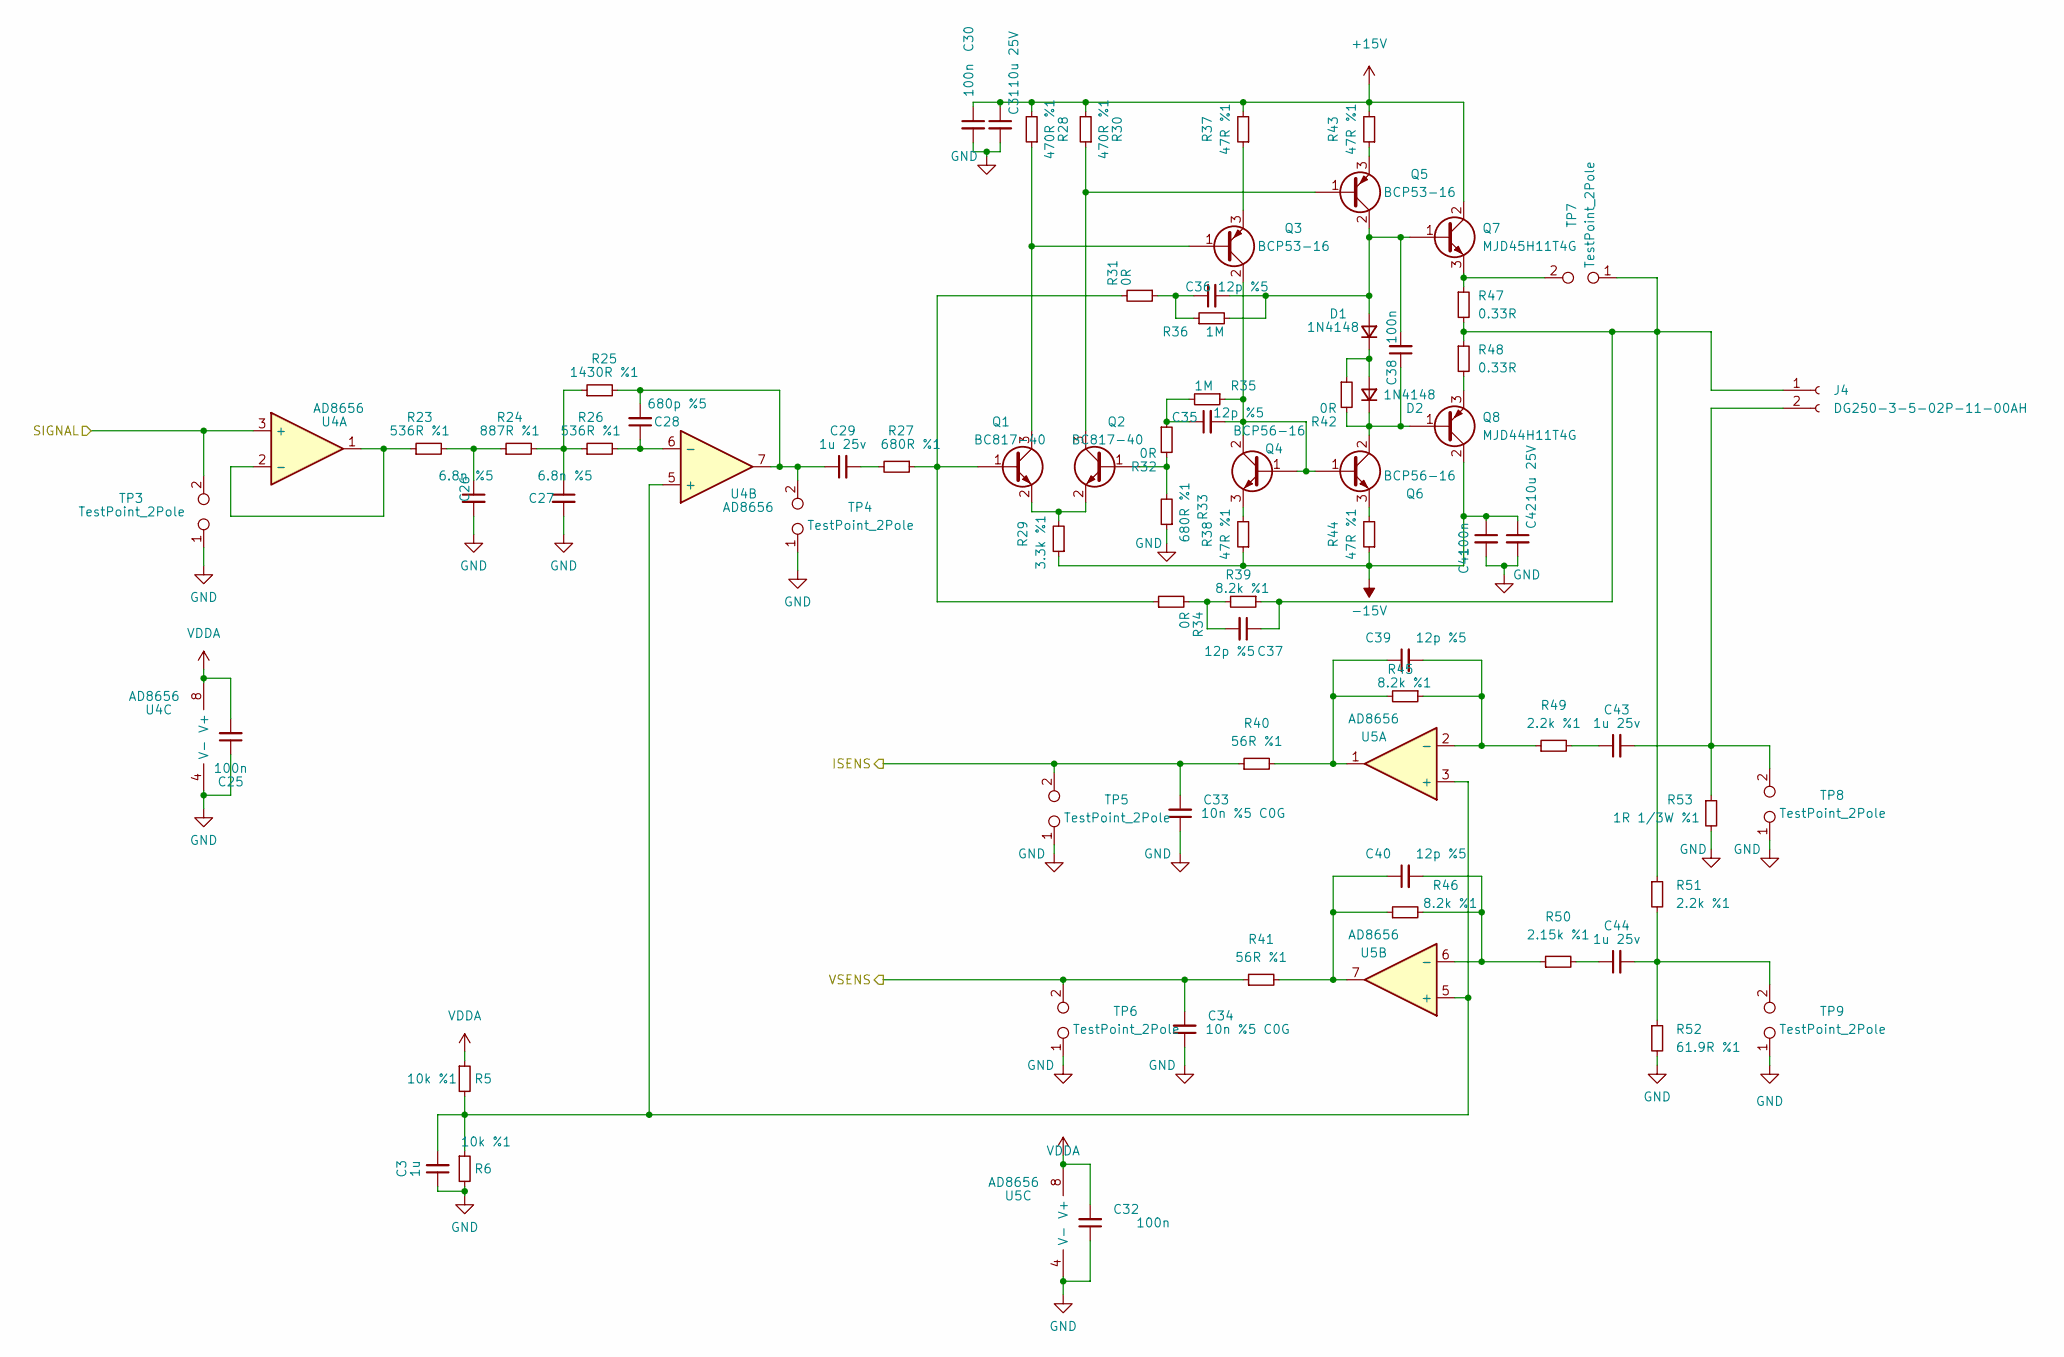
[picture p6: schematic ultrasonic.kicad_sch]

Parts:
C3: 1u; C_0603_1608Metric_Pad1.08x0.95mm_HandSolder
C25, C30, C32, C38, C41: 100n; C_0603_1608Metric_Pad1.08x0.95mm_HandSolder
C26, C27: 6.8n %5; C_0805_2012Metric_Pad1.18x1.45mm_HandSolder
C28: 680p %5; C_0603_1608Metric_Pad1.08x0.95mm_HandSolder
C29, C43, C44: 1u 25v; C_0603_1608Metric_Pad1.08x0.95mm_HandSolder
C31, C42: 10u 25V; C_1206_3216Metric_Pad1.33x1.80mm_HandSolder
C33, C34: 10n %5 C0G; C_0603_1608Metric_Pad1.08x0.95mm_HandSolder
C35, C36, C37, C39, C40: 12p %5; C_0603_1608Metric_Pad1.08x0.95mm_HandSolder
D1, D2: 1N4148; D_SOD-123
J4: DG250-3-5-02P-11-00AH
Q1, Q2: BC817-40; SOT-23
Q3, Q5: BCP53-16; SOT-223
Q4, Q6: BCP56-16; SOT-223
Q7: MJD45H11T4G; TO-252-2
Q8: MJD44H11T4G; TO-252-2
R5, R6: 10k %1; R_0603_1608Metric_Pad0.98x0.95mm_HandSolder
R23, R26: 536R %1; R_0603_1608Metric_Pad0.98x0.95mm_HandSolder
R24: 887R %1; R_0603_1608Metric_Pad0.98x0.95mm_HandSolder
R25: 1430R %1; R_0603_1608Metric_Pad0.98x0.95mm_HandSolder
R27, R33: 680R %1; R_0603_1608Metric_Pad0.98x0.95mm_HandSolder
R28, R30: 470R %1; R_0603_1608Metric_Pad0.98x0.95mm_HandSolder
R29: 3.3k %1; R_0603_1608Metric_Pad0.98x0.95mm_HandSolder
R31, R32, R34, R42: 0R; R_0603_1608Metric_Pad0.98x0.95mm_HandSolder
R35, R36: 1M; R_0603_1608Metric_Pad0.98x0.95mm_HandSolder
R37, R38, R43, R44: 47R %1; R_0603_1608Metric_Pad0.98x0.95mm_HandSolder
R39, R45, R46: 8.2k %1; R_0603_1608Metric_Pad0.98x0.95mm_HandSolder
R40, R41: 56R %1; R_0603_1608Metric_Pad0.98x0.95mm_HandSolder
R47, R48: 0.33R; R_2512_6332Metric_Pad1.40x3.35mm_HandSolder
R49, R51: 2.2k %1; R_0603_1608Metric_Pad0.98x0.95mm_HandSolder
R50: 2.15k %1; R_0603_1608Metric_Pad0.98x0.95mm_HandSolder
R52: 61.9R %1; R_0603_1608Metric_Pad0.98x0.95mm_HandSolder
R53: 1R 1/3W %1; R_1210_3225Metric_Pad1.30x2.65mm_HandSolder
TP3, TP4, TP5, TP6, TP7, TP8, TP9: TestPoint_2Pole; PinHeader_1x02_P2.54mm_Vertical
U4, U5: AD8656; SOIC-8_3.9x4.9mm_P1.27mm

Connections:
+15V: C30.1, C31.1, Q7.2 (C), R28.2, R30.2, R37.2, R43.2
-15V: C41.1, C42.1, Q8.2 (C), R29.1, R38.1, R44.1
GND: C3.1, C25.1, C26.2, C27.2, C30.2, C31.2, C32.1, C33.1, C34.1, C41.2, C42.2, R6.2, R33.1, R52.2, R53.2, TP3.1, TP4.1, TP5.1, TP6.1, TP8.1, TP9.1, U4.4 (V-), U5.4 (V-)
ISENS: C33.2, R40.1, TP5.2
unnamed: C3.2, R5.2, R6.1, U4.5 (+), U5.3 (+), U5.5 (+)
unnamed: C26.1, R23.2, R24.1
unnamed: C27.1, R24.2, R25.1, R26.1
unnamed: C28.1, R26.2, U4.6 (-)
unnamed: C28.2, C29.1, R25.2, TP4.2, U4.7
unnamed: C29.2, R27.2
unnamed: C35.1, R32.1, R35.2
unnamed: C35.2, Q3.2 (C), Q3.4 (C), Q4.1 (B), Q4.2 (C), Q4.4 (C), Q6.1 (B), R35.1
unnamed: C36.1, R31.1, R36.1
unnamed: C36.2, C38.2, D1.2 (A), Q5.2 (C), Q5.4 (C), Q7.1 (B), R36.2
unnamed: C37.1, J4.1, R39.1, R47.2, R48.1, R51.1, TP7.1
unnamed: C37.2, R34.2, R39.2
unnamed: C38.1, D2.1 (K), Q6.2 (C), Q6.4 (C), Q8.1 (B), R42.2
unnamed: C39.1, R40.2, R45.2, U5.1
unnamed: C39.2, R45.1, R49.1, U5.2 (-)
unnamed: C40.1, R41.2, R46.1, U5.7
unnamed: C40.2, R46.2, R50.1, U5.6 (-)
unnamed: C43.1, R49.2
unnamed: C43.2, J4.2, R53.1, TP8.2
unnamed: C44.1, R50.2
unnamed: C44.2, R51.2, R52.1, TP9.2
unnamed: D1.1 (K), D2.2 (A), R42.1
unnamed: Q1.1 (B), R27.1, R31.2, R34.1
unnamed: Q1.2 (E), Q2.2 (E), R29.2
unnamed: Q1.3 (C), Q3.1 (B), R28.1
unnamed: Q2.1 (B), R32.2, R33.2
unnamed: Q2.3 (C), Q5.1 (B), R30.1
unnamed: Q3.3 (E), R37.1
unnamed: Q4.3 (E), R38.2
unnamed: Q5.3 (E), R43.1
unnamed: Q6.3 (E), R44.2
unnamed: Q7.3 (E), R47.1, TP7.2
unnamed: Q8.3 (E), R48.2
unnamed: R23.1, U4.1, U4.2 (-)
SIGNAL: TP3.2, U4.3 (+)
VDDA: C25.2, C32.2, R5.1, U4.8 (V+), U5.8 (V+)
VSENS: C34.2, R41.1, TP6.2
