onurefe/Wirebonder/Hardware/zmotor.kicad_sch

## KiCad design Hardware/zmotor.kicad_sch (2024-12-15, an earlier design)

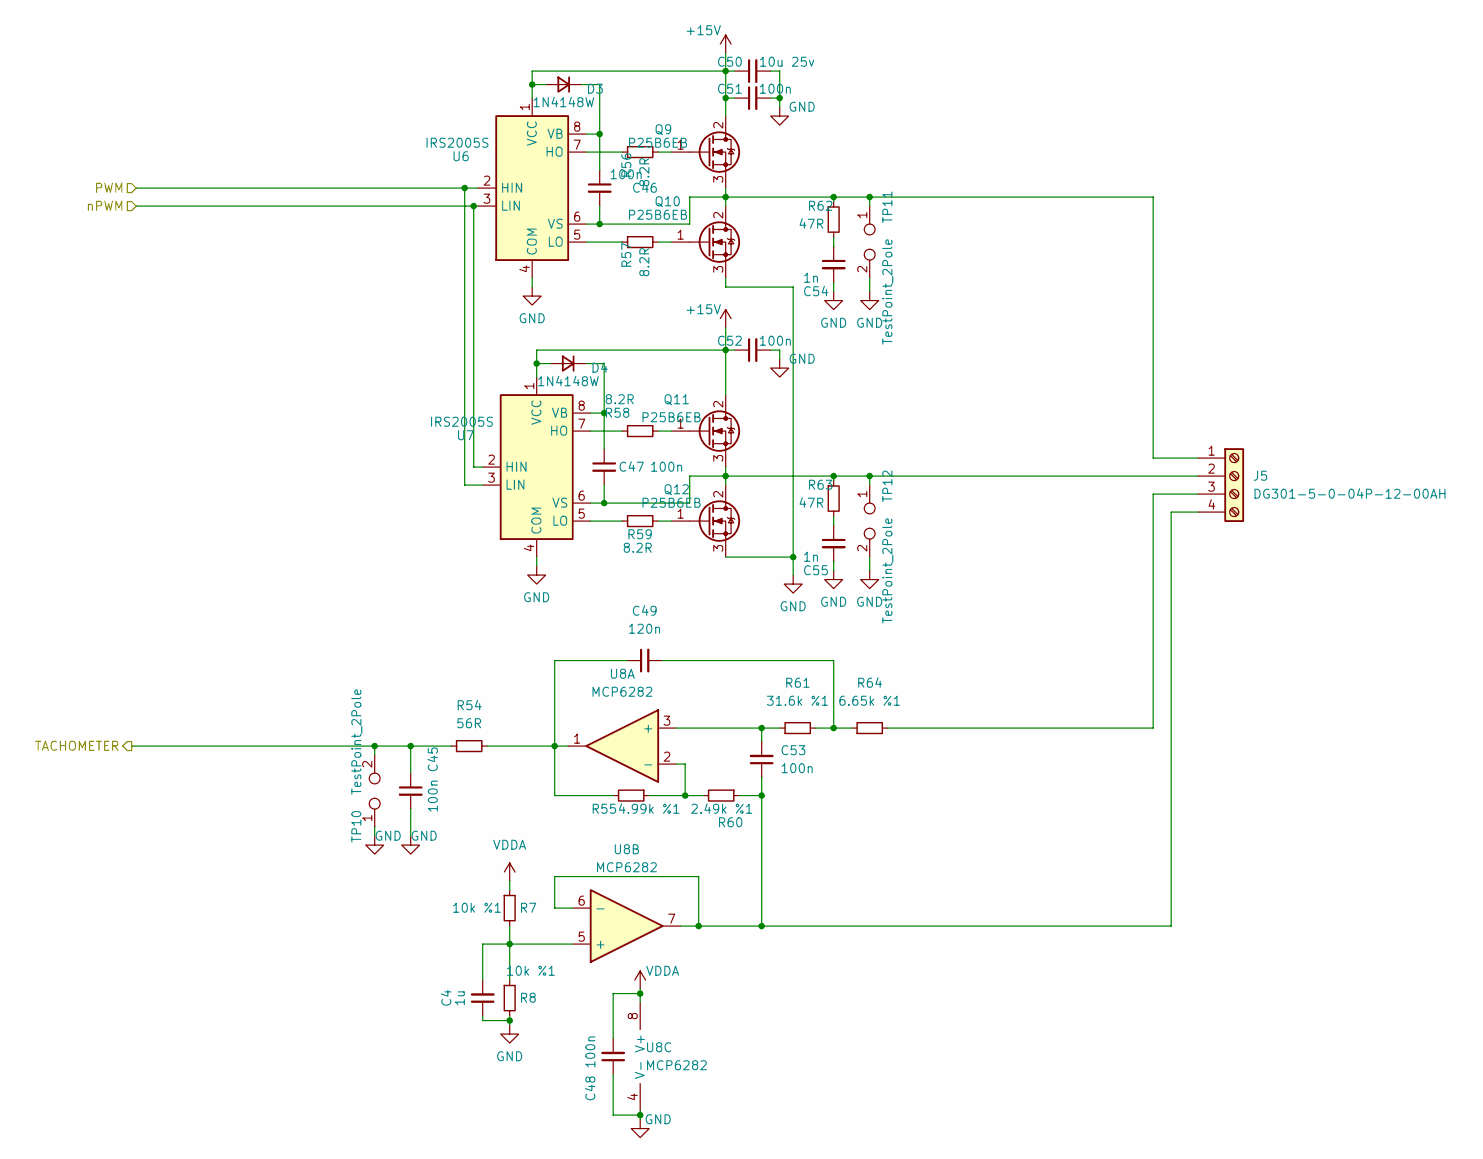
[picture p7: schematic zmotor.kicad_sch]

Parts:
C4: 1u; C_0603_1608Metric_Pad1.08x0.95mm_HandSolder
C45, C46, C47, C48, C51, C52, C53: 100n; C_0603_1608Metric_Pad1.08x0.95mm_HandSolder
C49: 120n; C_0805_2012Metric_Pad1.18x1.45mm_HandSolder
C50: 10u 25v; C_0805_2012Metric_Pad1.18x1.45mm_HandSolder
C54, C55: 1n; C_0603_1608Metric_Pad1.08x0.95mm_HandSolder
D3, D4: 1N4148W; D_SOD-123
J5: DG301-5-0-04P-12-00AH; DG301-5.0-04P-12-00AH
Q9, Q10, Q11, Q12: P25B6EB; TO-252-2
R7, R8: 10k %1; R_0603_1608Metric_Pad0.98x0.95mm_HandSolder
R54: 56R; R_0603_1608Metric_Pad0.98x0.95mm_HandSolder
R55: 4.99k %1; R_0603_1608Metric_Pad0.98x0.95mm_HandSolder
R56, R57, R58, R59: 8.2R; R_0603_1608Metric_Pad0.98x0.95mm_HandSolder
R60: 2.49k %1; R_0603_1608Metric_Pad0.98x0.95mm_HandSolder
R61: 31.6k %1; R_0603_1608Metric_Pad0.98x0.95mm_HandSolder
R62, R63: 47R; R_0603_1608Metric_Pad0.98x0.95mm_HandSolder
R64: 6.65k %1; R_0603_1608Metric_Pad0.98x0.95mm_HandSolder
TP10, TP11, TP12: TestPoint_2Pole; PinHeader_1x02_P2.54mm_Vertical
U6, U7: IRS2005S; SOIC-8_3.9x4.9mm_P1.27mm
U8: MCP6282; SOIC-8_3.9x4.9mm_P1.27mm

Connections:
+15V: C50.1, C51.1, C52.1, D3.2 (A), D4.2 (A), Q9.2 (D), Q11.2 (D), U6.1 (VCC), U7.1 (VCC)
GND: C4.1, C45.2, C48.1, C50.2, C51.2, C52.2, C54.2, C55.2, Q10.3 (S), Q12.3 (S), R8.2, TP10.1, TP11.2, TP12.2, U6.4 (COM), U7.4 (COM), U8.4 (V-)
unnamed: C4.2, R7.2, R8.1, U8.5 (+)
unnamed: C46.1, D3.1 (K), U6.8 (VB)
unnamed: C46.2, J5.1, Q9.3 (S), Q10.2 (D), R62.1, TP11.1, U6.6 (VS)
unnamed: C47.1, D4.1 (K), U7.8 (VB)
unnamed: C47.2, J5.2, Q11.3 (S), Q12.2 (D), R63.1, TP12.1, U7.6 (VS)
unnamed: C49.1, R54.2, R55.2, U8.1
unnamed: C49.2, R61.2, R64.1
unnamed: C53.1, J5.4, R60.1, U8.6 (-), U8.7
unnamed: C53.2, R61.1, U8.3 (+)
unnamed: C54.1, R62.2
unnamed: C55.1, R63.2
unnamed: J5.3, R64.2
unnamed: Q9.1 (G), R56.2
unnamed: Q10.1 (G), R57.2
unnamed: Q11.1 (G), R58.2
unnamed: Q12.1 (G), R59.2
unnamed: R55.1, R60.2, U8.2 (-)
unnamed: R56.1, U6.7 (HO)
unnamed: R57.1, U6.5 (LO)
unnamed: R58.1, U7.7 (HO)
unnamed: R59.1, U7.5 (LO)
PWM: U6.2 (HIN), U7.3 (LIN)
TACHOMETER: C45.1, R54.1, TP10.2
VDDA: C48.2, R7.1, U8.8 (V+)
nPWM: U6.3 (LIN), U7.2 (HIN)
