onurefe/Wirebonder/(commit log)

2022-07-04 Force coil driver & lever DC motor H bridge added.
    +TODO: Check if there is a better way to drive coil(getting rid of schottky diode)
    [Wirebonder.kicad_pcb, Wirebonder.kicad_sch, force_coil.kicad_sch, interface.kicad_sch, lever.kicad_sch, mcu.kicad_sch, piezo.kicad_sch, stepper.kicad_sch]
2022-07-05 Polished coil driver. H bridge driver needs more work.
    [Wirebonder.kicad_sch, force_coil.kicad_sch, lever.kicad_sch]
2022-07-14 Piezo transducer driver added(transistor amplifier part).
    [Wirebonder.kicad_sch, piezo.kicad_sch]
2022-07-25 Changes about piezo transducer driver
    + Regarding measurement of piezo transducer impedance, driver circuit is updated.(-+15v). Besides circuit is updated. But yet to be simulated for new resistance values.
    + Most cost efficient analog design(up to now) is created. Noise free enough, but nothing more.
    [Wirebonder.kicad_sch, force_coil.kicad_sch, lever.kicad_sch, piezo.kicad_sch]
2022-08-09 Completed schematic and PCB.
    [BOM.xlsx, Wirebonder.kicad_sch, communication.kicad_sch, contact_sensors.kicad_sch, drives.kicad_sch, force_coil.kicad_sch, interface.kicad_sch, lever.kicad_sch]
2022-08-10 Few coonector footprint modifications and silkscreen additions to them.
    [Wirebonder-B_Cu.gbl, Wirebonder-B_Mask.gbs, Wirebonder-B_Paste.gbp, Wirebonder-B_Silkscreen.gbo, Wirebonder-Edge_Cuts.gm1, Wirebonder-F_Cu.gtl, Wirebonder-F_Mask.gts, Wirebonder-F_Paste.gtp]
2024-12-15 Toolchain set. Timer module added. Schematic files migrated.
    [Wirebonder.kicad_sch, contact_sensors.kicad_sch, drives.kicad_sch, force_coil.kicad_sch, interface.kicad_sch, lvdt.kicad_sch, mcu.kicad_sch, regulators.kicad_sch]
2024-12-22 Addition lvdt, adc_dispatcher, stepper, timer, fast_io modules.
    [bom.xlsx, configuration.h]
2025-02-08 Sketch module codes. To be corrected/synthesized.
    [force_coil_driver.c, force_coil_driver.h, generic.h, pid_controller.c, pid_controller.h, pll.c, pll.h, tachometer.c]
2025-02-09 Tidying up code. Following modules are clearified. - ADC dispatcher. - Force coil driver. - LVDT signal generator.
    [configuration.h]
2025-02-09 Clearing, fixing and rewriting the following modules. - Tachometer. - Z motor control. - LVDT. - ADC dispacther.
    [configuration.h]
2025-02-10 - PLL module added. - Ultrasonic driver added.
    [configuration.h]
2025-02-11 - Addition of impedance scanner module.
    [configuration.h]
2025-02-12 Following modules are added as well as code improvements. - Pin monitor. - Solenoid driver. - Robot (inital sketches).
    [configuration.h]
2025-02-13 - Router module encapsulation stepper module is written. - Stepper and router are adapted.
    [configuration.h]
2025-02-14 - Robot module incomplete sketch. - Timer expire module.
    [configuration.h]
2025-02-16 Semi-auto bonding program is coded to bonder module.
    [configuration.h]
